AltamarMx/LabModularCalor/practicas/README.md

# Guía de prácticas del Laboratorio Modular de Transferencia de Calor

La presente guía de prácticas es un conjunto reducido de experimentos
que se pueden llevar a cabo con el **_Laboratorio Modular de Transferencia de Calor (LMTC)_**,
pero debe tener muy conciente la/el lector que la imaginación es el límite.

También es una guía para la/el profesora que imparte el curso de _Transferencia
de Calor_ o su similar.

Te invito a ti, a proponer una práctica y hacer crecer esta sección del LMTC.

Prácticas sugeridas:
1. [Cálculo de la conductividad térmica de una placa](https://github.com/AltamarMx/LabModularCalor/blob/main/practicas/conductividad_termica.md)
2. [Cálculo la resistencia térmica y perfil de temperatura en estado estacionario](https://github.com/AltamarMx/LabModularCalor/blob/main/practicas/resistencia_termica.md)
3. [Efecto de la masa térmica en materiales del mismo espesor y diferente densidad](https://github.com/AltamarMx/LabModularCalor/blob/main/practicas/masa_termica.md)
4. [Coeficiente convectivo](https://github.com/AltamarMx/LabModularCalor/blob/main/practicas/coeficiente_convectivo.md)
5. [Evaluación de disipadores de calor](https://github.com/AltamarMx/LabModularCalor/blob/main/practicas/evaluacion_intercambiador.md)
6. [Intercambio radiativo](https://github.com/AltamarMx/LabModularCalor/blob/main/practicas/intercambio_radiativo.md)
7. [Absortancia solar](https://github.com/AltamarMx/LabModularCalor/blob/main/practicas/absortancia_solar.md)
