AltamarMx/LabModularCalor/practicas/intercambio_radiativo.md

Objetivo: Evaluar el intercambio radiativo como función de la distancia de la fuente radiativa a un punto.

Material:
* 1 Dispositivo de adquisición y visualización de datos o Plataforma IoT
* 1 Dispositivo para medir temperatura y flujo de calor
* 1 Fuente radiativa (foco incandescente, vela, encendedor )

Instrucciones:
Arma el arreglo experimental como se muestra en la figura anexa, coloca el sensor de flujo de calor a una distancia d con la superficie perpendicular a la línea imaginaria que une a la superficie y a la fuente.

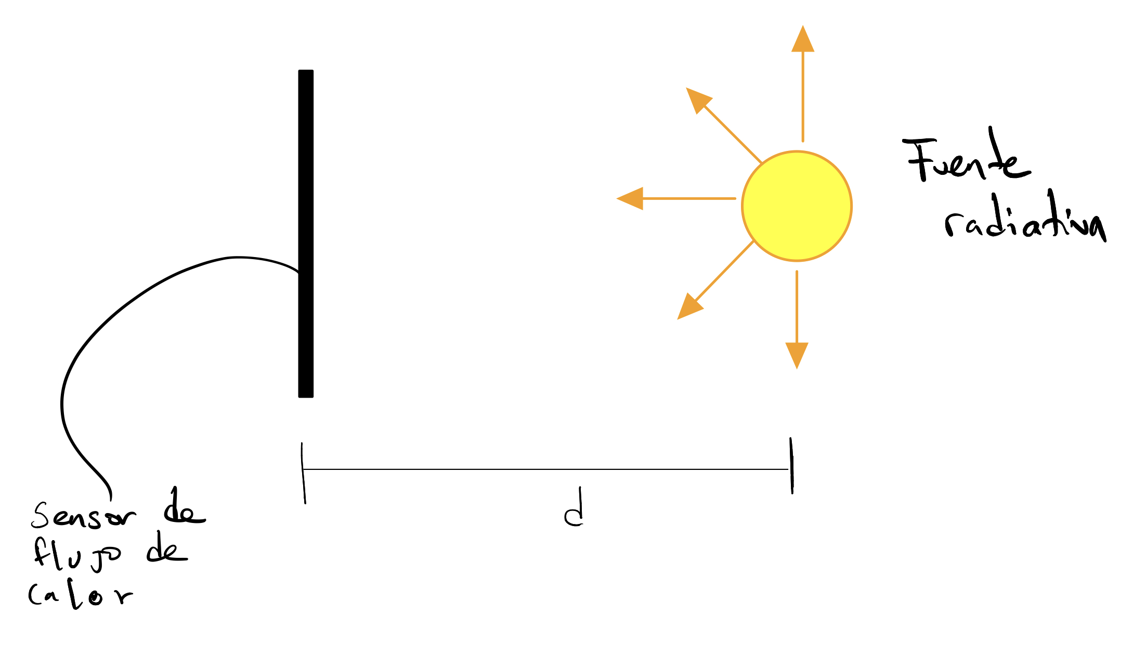
[picture p1: practicas/img/intercambio_radiativo_esquema.jpeg]
“Login”


Mide el flujo de calor que registra el sensor a diferentes distancias.
Cambia la orientación del sensor hacia la fuente de luz y mide otra vez el flujo de calor
a las mismas distancias.

Actividades:
* Grafica el flujo de calor como función de la distancia para una orientación del sensor ¿Qué observas ?
* Grafica el flujo de calor a una distancia y diferentes orientaciones ¿Qué observas?

Actividades sugeridas:
* ¿Qué mediciones necesitas para poder calcular el factor de vista en este experimento?
