AltamarMx/LabModularCalor/practicas/absortancia_solar.md

Objetivo: Evaluar el efecto de la absortancia solar en el intercambio radiativo.

Material:
* 1 Dispositivo de adquisición y visualización de datos o Plataforma IoT
* 1 Dispositivo para medir temperatura y flujo de calor
* 3 cajas de cartón cerradas de 5cm x 5cm x 5cm, una blanca y una negra y una forrada de papel aluminio.

Instrucciones:
Arma el arreglo experimental como se muestra en la figura anexa, coloca el sensor de temperatura al centro de la caja cuidando que en las tres cajas quede el  termopar en la misma posición.

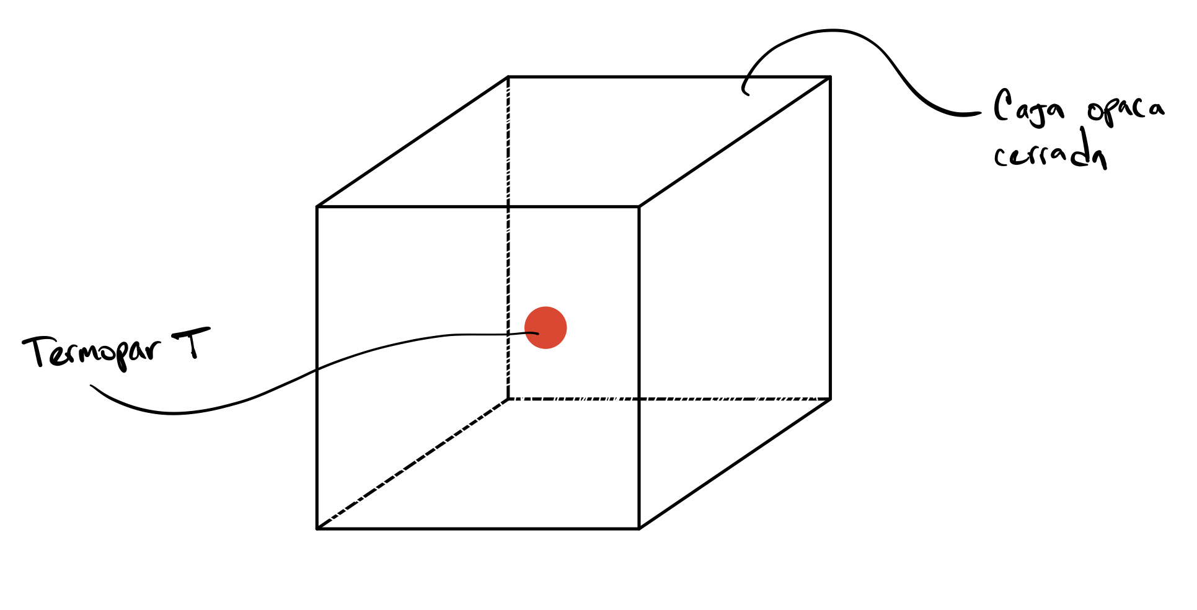
[picture p2: practicas/img/absortancia_solar_esquema.jpeg]
“Login”


Saca las tres cajas al sol cuidando que no se produzcan sombreamientos entre ellas y que tampoco reciban sombreamiento
por otros elementos.

Actividades:
* Mide la temperatura del aire como función del tiempo ¿Qué observas?

Actividades sugerias:
* Calculando el volumen de aire de la caja, y asumiendo que un calor específico constante, calcula el flujo de calor
solar recibido por cada caja.
