AltamarMx/LabModularCalor/practicas/evaluacion_intercambiador.md

Objetivo: Evaluar dos disipadores de calor.

Material:
* 1 Dispositivo de adquisición y visualización de datos o Plataforma IoT
* 1 Dispositivo para medir temperatura y flujo de calor
* 1 Dispositivos de condición de frontera a temperatura constante
* 2 disipadores de calor de aleta
* Pasta térmica para unir las piezas

Instrucciones:
Consigue 2 intercambiadores de calor diferentes, es importante que sea diferentes como los mostrados a continuación:

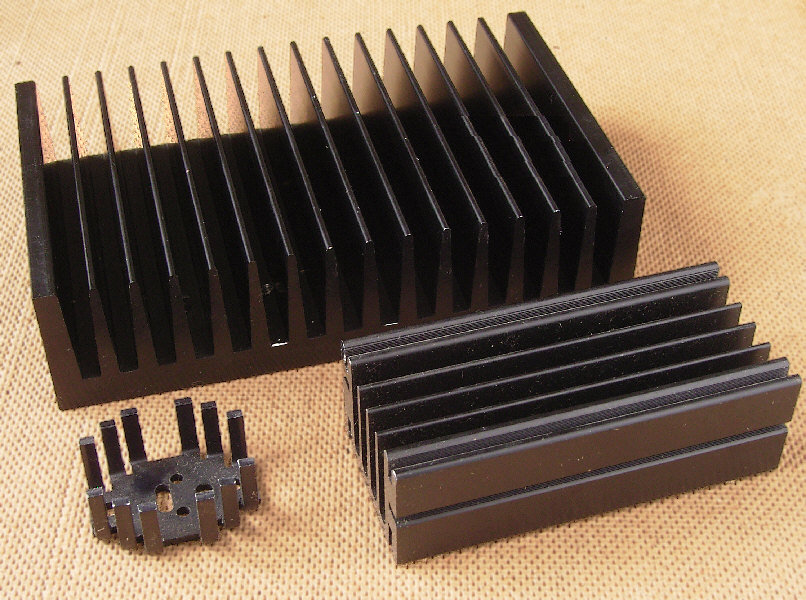
[picture p3: practicas/img/disipador1.jpg]


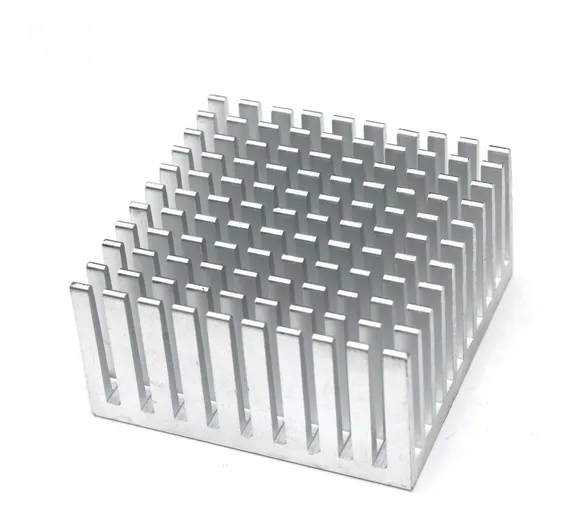
[picture p4: practicas/img/disipador2.png]
 

Arma el arreglo experimental como se muestra en la figura anexa,  establece la celda Peltier a temperatura constantes. Coloca el sensor de flujo de calor.

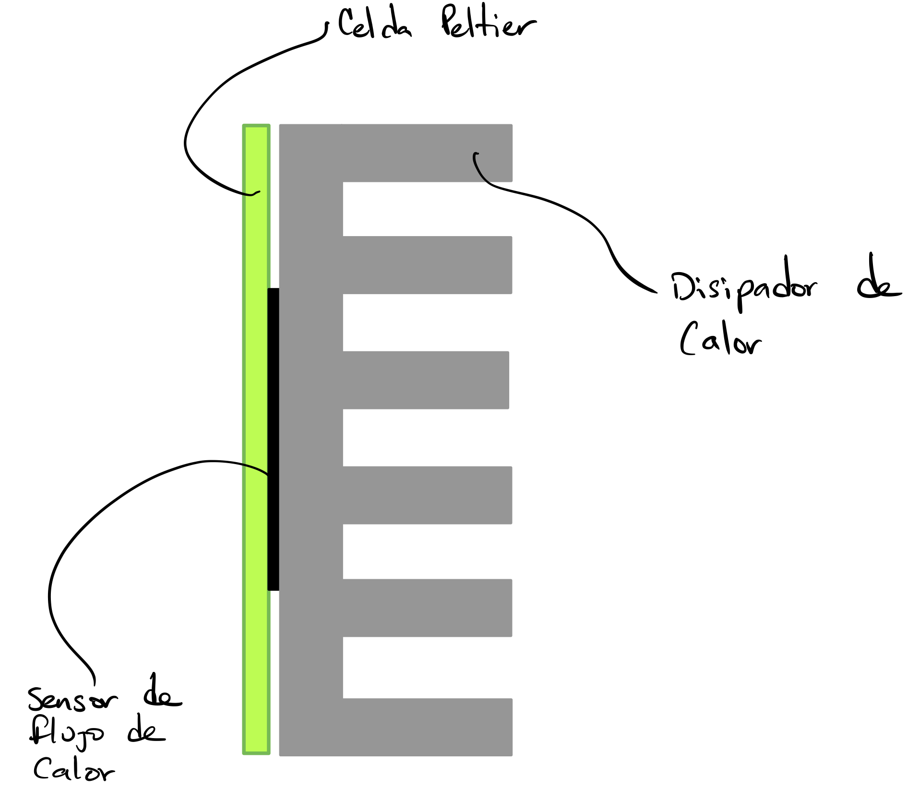
[picture p5: practicas/img/disipador_esquema.jpeg]


Mide el flujo de calor y espera a alcanzar el estado permanente. Cálcula el coeficiente convectivo.
Cambia el disipador de calor y vuelve a medir el flujo de calor y a calcular el coeficiente convectivo.

Actividades:
* Compara los valores de flujo de calor de los dos disipadores ¿Qué observas?
* Compara los valores calculados del coeficiente convectivo en los dos disipadores ¿Qué observas?

Actividades sugeridas:
* Cambia la orientación del disipador de calor ¿Observas alguna diferencia?
* Si rocias un poco de alcohol sobre el disipador ¿Observas alguna diferencia?
