AltamarMx/LabModularCalor/practicas/coeficiente_convectivo.md

Instrucciones:

Objetivo: Analizar el efecto del viento en el coeficiente convectivo.

Material:
* 1 Dispositivo de adquisición y visualización de datos o Plataforma IoT
* 1 Dispositivo para medir temperatura y flujo de calor
* 1 Dispositivos de condición de frontera a temperatura constante
* Pasta térmica para unir piezas
* 1 Ventilador

Instrucciones:

Arma el arreglo experimental como se muestra en la  figura, coloca cada uno de los dispositivos de condición de frontera a temperaturas diferentes y valores constantes. Coloca un sensor de flujo de calor y un termopar
sobre la celda Peltier. Mide también la temperatura ambiente. Establece la celda Peltier a un valor constante.

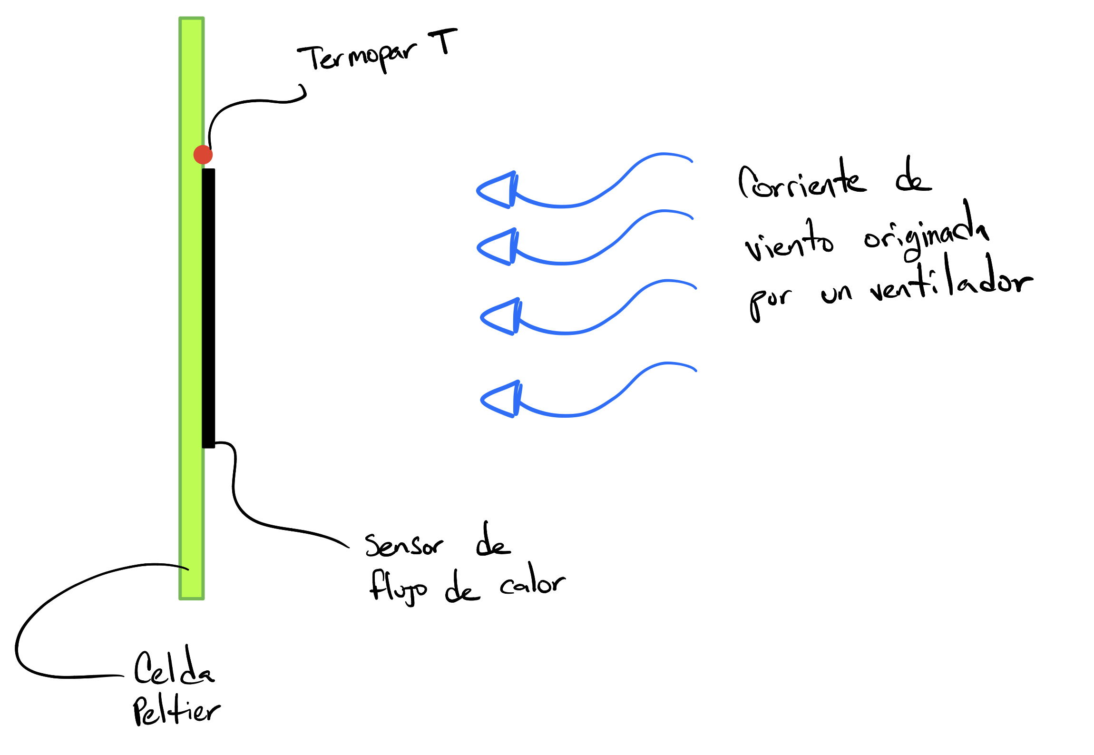
[picture p6: practicas/img/coeficiente_convectivo_esquema.jpeg]
“Login”


Mide la temperatura de la superficie de la celda Peltier, la temperatura del aire y el flujo de calor.
Calcula el coeficiente convectivo usando la formula:
q/A = h dT
donde q/A es el flujo de calor por unidad de área medido por el sensor de flujo de calor, h es el coeficiente convectivo y dT la diferencia de temperatura entre la superficie y el ambiente.
Varía la velocidad del aire y calcula el coeficiente convectivo para cada velocidad diferente.

Realiza las siguientes actividades:
* Compara los cálculos de los diferentes coeficientes convectivos para las diferentes velocidades del aire ¿Qué observas?
* Compara las mediciones de flujo de calor para los diferentes experimentos ¿Qué observas?

Actividades sugeridas:
*  Utiliza una correlación del coeficiente convectivo para determinar de manera indirecta la velocidad del viento.
