AltamarMx/LabModularCalor/practicas/resistencia_termica.md

Objetivo: Medir la resistencia térmica de un conjunto de capas homogéneas y visualizar
el perfil de temperaturas en estado estacionario.

Material:
* 1 Dispositivo de adquisición y visualización de datos o Plataforma IoT
* 2 Dispositivo para medir temperatura y flujo de calor
* 2 dispositivos de condición de frontera a temperatura constante
* 3 muestras de diferente material de  1" x 1" con espesor de máximo 1 cm
* Pasta térmica para unir las piezas

Instrucciones:

Arma el arreglo experimental como se muestra en la  figura, coloca cada uno de los dispositivos de condición de frontera a temperaturas diferentes y valores constantes. Coloca dos sensores de flujo de calor y cuatro
termopares como se indica en la figura.

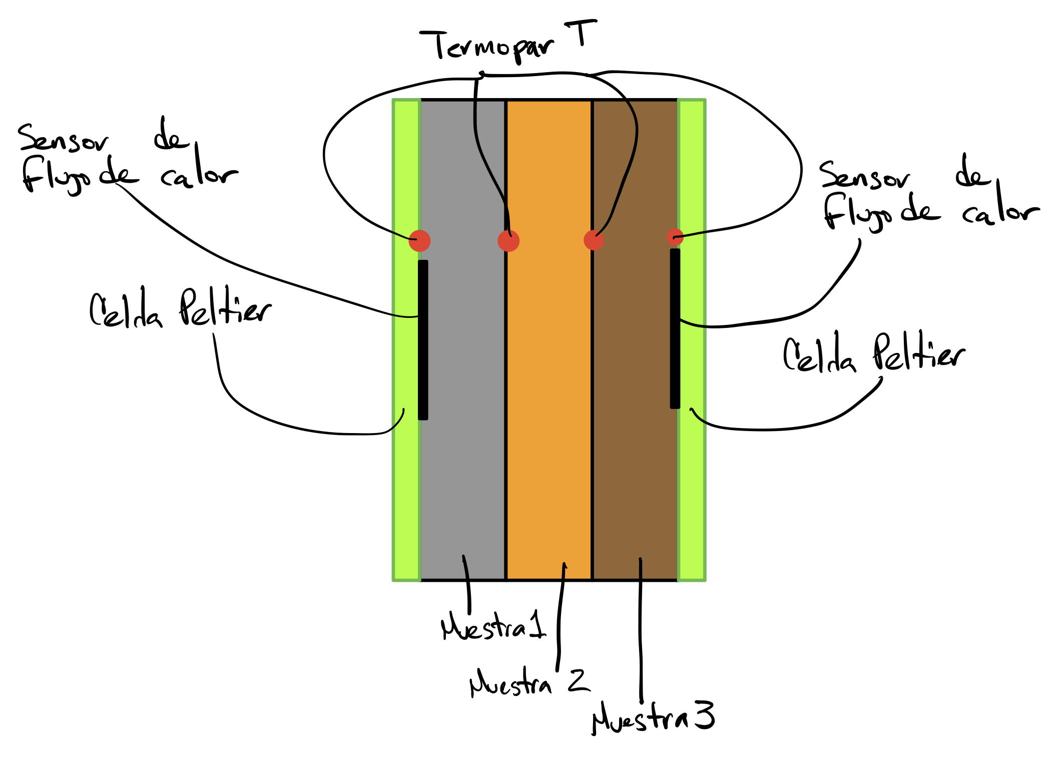
[picture p7: practicas/img/resistencia_esquema.jpeg]
“Login”


Visualiza los valores de temperatura y flujo de calor en los dispositivos de adquisición. Una vez que el sistema ha alcanzado el estado permanente usa esos valores de temperatura y flujo de calor para calcular la resistencia térmica usando la siguiente ecuación:

q/A = dT /  Rt

donde q es el flujo de calor, A es el área de la muestra, dT la diferencia de temperatura entre las superficies y Rt la resistencia térmica de la muestra.

Realiza las siguientes actividades:
Establece la temperatura de las celdas Peltier a diferentes temperaturas y calcula para cada dT la resistencia térmica y grafica este valor. ¿Qué observas?

Actividades sugeridas:
* Calcula y grafica el perfil de temperatura que debe tener una muestra con una resistencia térmica equivalente, grafica y compara con los datos experimentales y comenta las semejanzas o diferencias.
* Intercambia el orden de las muestras y vuelve a realizar los experimentos.
