AltamarMx/LabModularCalor/practicas/conductividad_termica.md

Objetivo: Medir la conductividad térmica de diferentes muestras de materiales homogénes de una sola capa.

Material:
* 1 Dispositivo de adqusición y visualización de datos o Plataforma IoT
* 1 Dispositivo para medir temperatura y flujo de calor
* 2 dispositivos de condición de frontera a temperatura constante
* 2 muestras de diferente material de  1" x 1" con espesor de máximo 1 cm
* Pasta térmica para unir las piezas

Instrucciones:
Arma el arreglo experimental como se muestra en la figura anexa, coloca cada uno de los dispositivos de condición de frontera a temperaturas diferentes y valores constantes. Coloca dos sensores de flujo de calor y dos termopares como se indica en la figura.

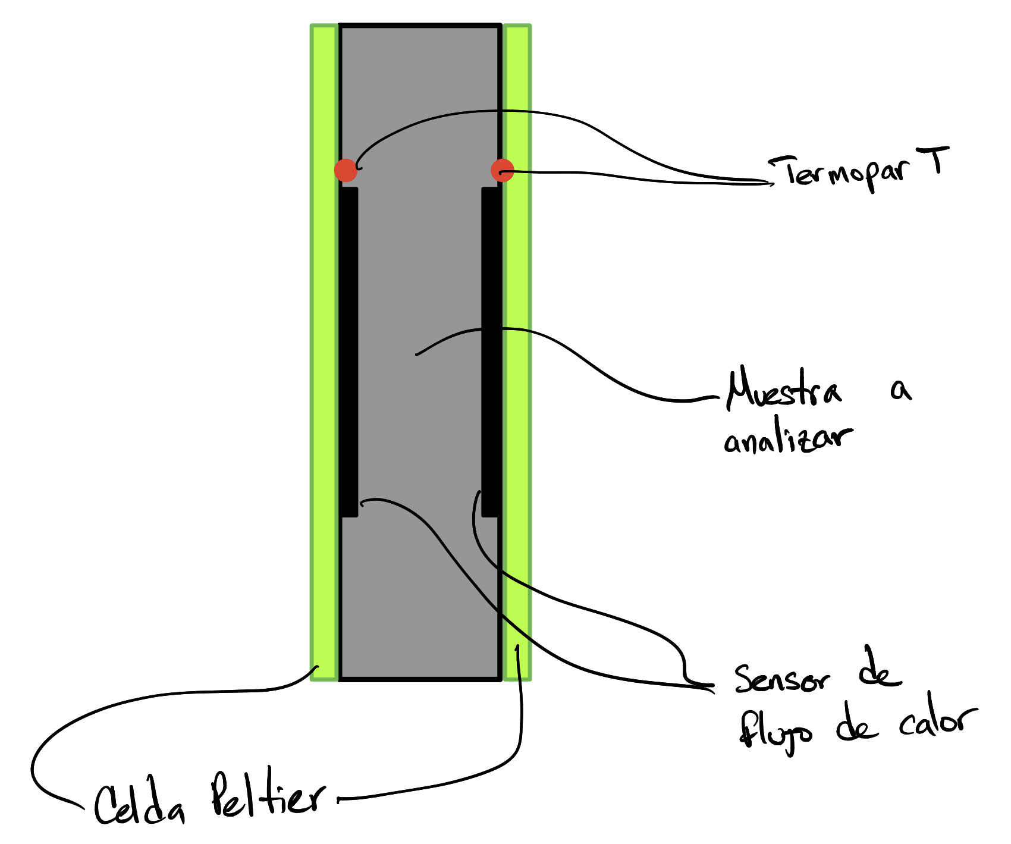
[picture p8: practicas/img/conductividad_esquema.jpeg]
“Login”


Visualiza los valores de temperatura y flujo de calor en el dispositivo de adquisición y visualización de datos o en la platoaforma IoT.
Una vez que el sistema ha alcanzado el estado permanente usa esos valores de temperatura y flujo de calor para calcular la conductividad térmica usando la siguiente ecuación:

q/A  = k dT / L

donde q es el flujo de calor, A es el área de la muestra, k la conductividad térmica, dT la diferencia de temperatura entre las superficies y L el espesor de la muestra.

Una vez que el experimento ha alcanzado el estado permanente, saca promedios de las lecturas durante el estado permanente , y repite para otra muestra.
Reporta los valores obtenidos para las dos muestras y comenta si los resultados son los esperados.

Actividades sugeridas:
* Demuestra con los valores de temperatura que el sistema ha alcanzado el estado permanente.
* Demuestra utilizando los sensores de flujo de calor, que el sistema ha alcanzado el estado permanente.
* Calcula y grafica la derivada temporal de la temperatura respecto al tiempo y comenta el comportamiento.
