AltamarMx/LabModularCalor/dispositivos/d3.md

# Dispositivo para generar condiciones de frontera

Este dispositivo genera condiciones de frontera de temperatura constante o una señal que varía sinusoidalmente en el tiempo.

Esto se logra con un microcontrolador esp8266, una placa Peltier, una fuente de alimentación, y una pantalla LCD para la interfaz. Dado que la placa Peltier requiere hasta 10 A de corriente, se requiere una fuente de potencia que entregue esta corriente y otra a 5V y 1 A para alimentar el esp8266. Además se cuenta con dos programas, uno para la condición de temperatura constante y otro para la condición de temperatura dependiente del tiempo.

El dispositvo ensamblado abierto y encendido se ve así:

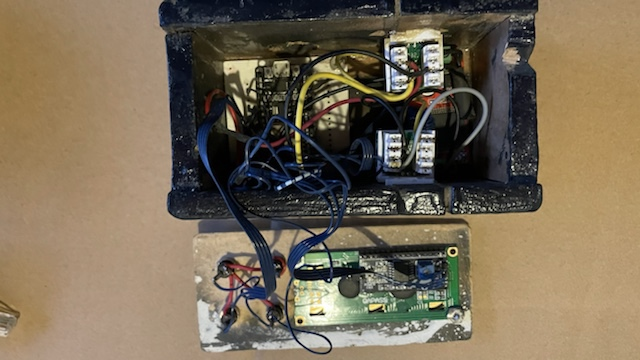
[picture p9: dispositivos/img/d3_abierto.jpeg]


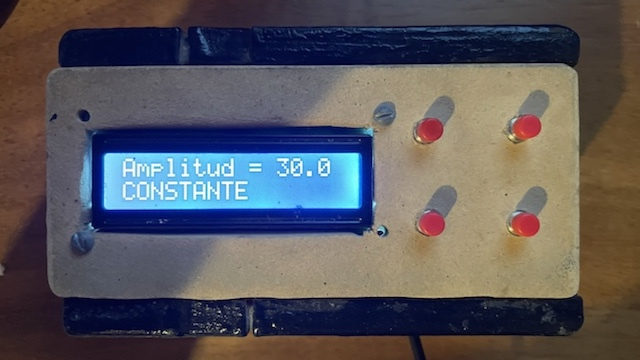
[picture p10: dispositivos/img/d3_encendido.jpeg]
 

En este caso, se cuentan con dos códigos:
1. [Condición de temperatura constante](https://github.com/AltamarMx/LabModularCalor/tree/main/dispositivos/d3/src/constante)
2. [Condición de temperatura sinusoidal](https://github.com/AltamarMx/LabModularCalor/tree/main/dispositivos/d3/src/sinusoidal)

El procedimiento para subir los programas al esp8266 son [estos](https://www.youtube.com/playlist?list=PLxG3HSH9-XK0j2GOKXZKbhOFE_pmVcxUO).

La lista de piezas es :  

1. 1 [esp8266](https://listado.mercadolibre.com.mx/esp8266#D[A:esp8266,L:undefined])
2. circuito de potencia para la celda Peltier basado en [Shield Monster Driver 30a Vnh2sp30 Puente H Pwm Arduino](https://articulo.mercadolibre.com.mx/MLM-563513242-puente-h-doble-30a-monster-moto-shield-vnh2sp30-arduinorobot-_JM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)
3. [Celda Peltier con disipador](https://articulo.mercadolibre.com.mx/MLM-690217405-kit-disipador-ventilador-celda-peltier-4x4cm-_JM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)
4. [Pantalla LCD](https://www.amazon.com.mx/tresd-print-tech-Pantalla-Compatible/dp/B08KL1H8F1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)
5. Fuente de potencia de 350 W con salidas de 3.3 V y 5 V

El esquemático de este dispositivo es:
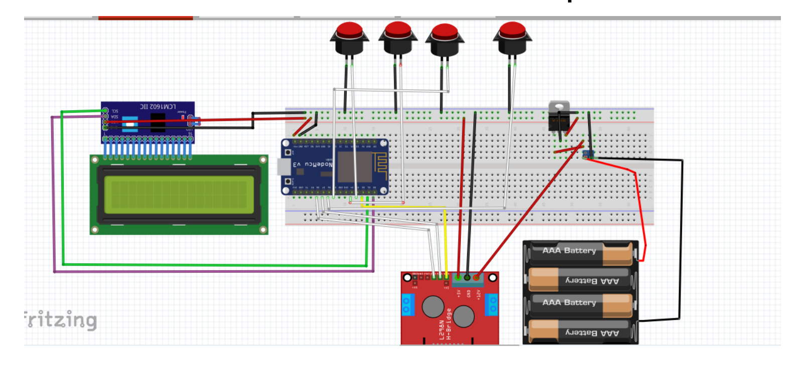
[picture p11: dispositivos/img/d3_esquematico.png]
