AltamarMx/LabModularCalor/dispositivos/d1.md

# Dispositivo de adquisición y visualización de datos

Este dispositivo se encarga de la adquisici'on y visualizaci'on de datos en tiempo real para los casos en que no se cuenta con una conexión inalámbrica a internet.

 Esto se logra con una RaspBerry Pi 3 en adelante, la instalación y configuración de ThingsBoard, que es una plataforma IoT y de la configuración correcta de la RaspBerry Pi.

 La lista de componentes es :  

 1. 1 RaspBerry Pi 3 en adelante
 2. Plataforma IoT ThingsBoard
 3. Tarjeta miniSD de al menos 4 GB y alta velocidad

Las instrucciones para instalar la plataforma IoT ThingsBoard
en la RaspBerry Pi se encuentran [aquí](https://thingsboard.io/docs/user-guide/install/rpi/)
