AltamarMx/LabModularCalor/dispositivos/d2.md

# Dispositivo para medir temperatura y flujo de calor

Este dispositivo es capaz de medir la temperatura en 4 puntos y el flujo de calor en una superficie de 1 pulgada cuadrada, adem'as, se conecta a la plataforma de IoT ThingsBoard donde se almacenan y visualizan los resultados en tiempo real.

 Esto se logra con un Arduino UNO, un esp8266, un shield para 4 termopares, un sensor de flujo de calor basado en efecto termopila, un circuito de ganancia para amplificar la señal del sensor de flujo de calor y el programa configurando una red inalámbrica para conectarse a la plataforma IoT.

 El dispositvo ensamblado abierto, junto con el sensor de flujo de calor se ve así:

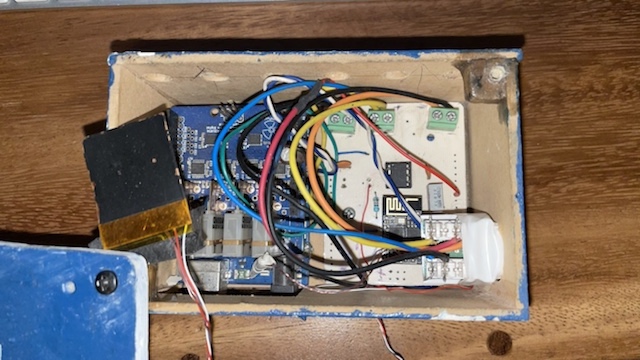
[picture p12: dispositivos/img/d2.jpeg]
 

 En este caso, se cuentan con un código:
 1. [Lectura de termopares, sensor de calor y publicación en ThingsBoard](https://github.com/AltamarMx/LabModularCalor/blob/main/dispositivos/d2/src/termopares_flujocalor_publicar.ino)

El esquemático del circuito de ganancia es:

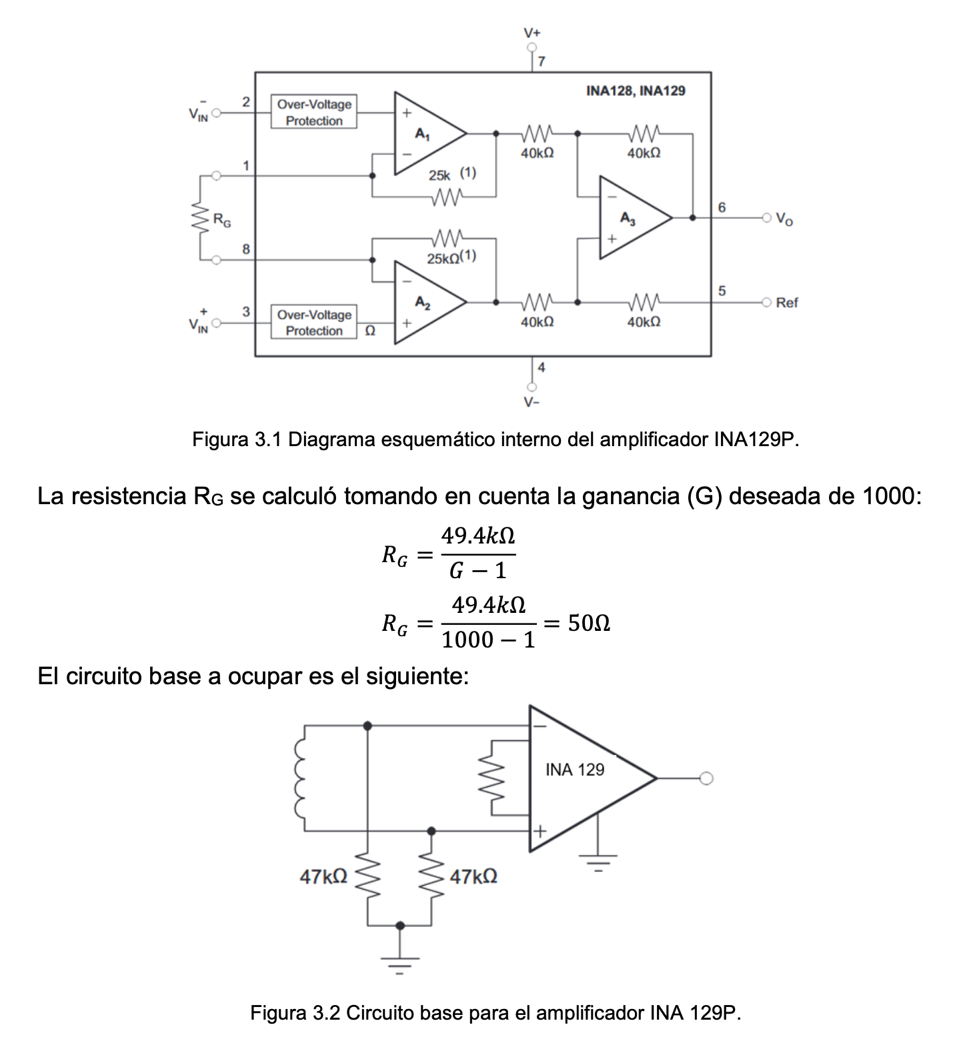
[picture p13: dispositivos/img/d2_esquematico_ganancia.png]
 

El esquemático del dispositivo completo es:

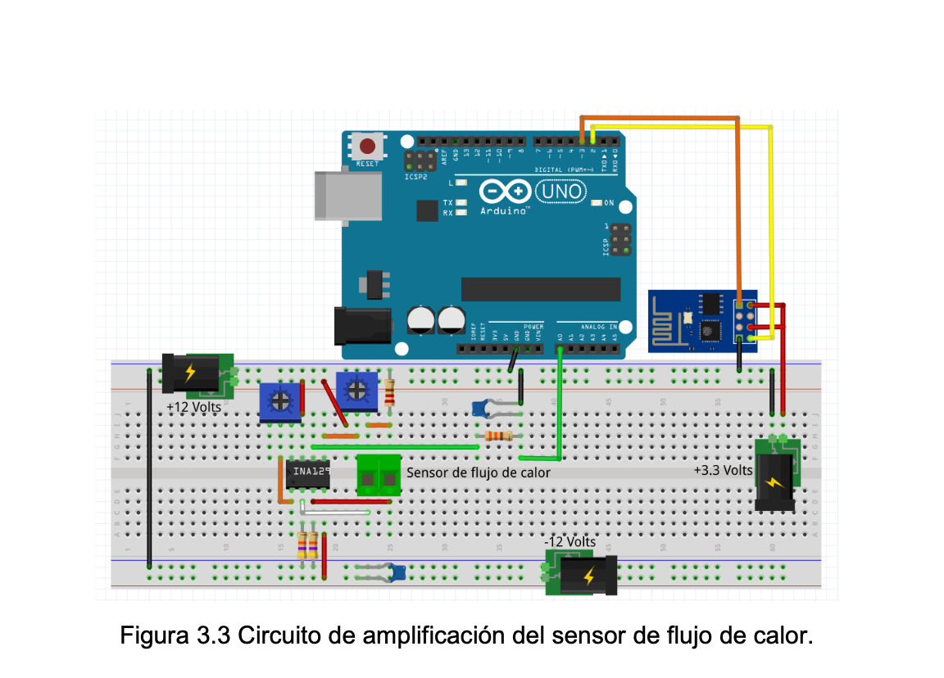
[picture p14: dispositivos/img/d2_esquematico_completo.png]
“d2_completo”
 

 La lista de piezas es :  

 1. 1 [Arduino Uno](https://store.arduino.cc/usa/arduino-uno-rev3)
 2. 1 [Shield para 4 termopares tipo T](https://www.playingwithfusion.com/productview.php?catid=1004&pdid=71)
 3. 1 [Sensor de flujo de calor](https://www.fluxteq.com/phfs-01e-heat-flux-sensor)
 4. 1 [esp12e](https://articulo.mercadolibre.com.mx/MLM-555159182-modulo-wifi-esp8266-esp-12f-esp8266-actualizacion-esp-12e-esp-12-compatible-con-arduino-nodemcu-_JM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)
 5. 4 Termopares tipo T
 6. 1 circuito de ganancia basado en el [INA129P](https://www.infinity-component.hk/product/Luminary-Micro-Texas-Instruments_INA129P.aspx)
