AltamarMx/LabModularCalor/dispositivos/d4.md

# Dispositivo simplificado para medir temperatura

Es el dispositivo más fácil y barato de recrear,
cuenta con 4 sensores digitales de temperatura conectados a un esp8266 con MicroPython, pero se pueden agregar más . Solo requiere configurar la red inalámbrica a la que se debe conectar y energizarse por medio de un cable micro USB por medio de una computadora, batería o cargador de celular.

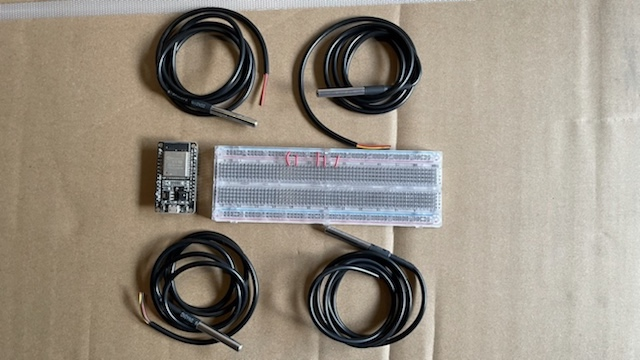
[picture p15: dispositivos/img/d4.jpeg]
“Login”


El código que se tiene que colocar en el esp8266 está [aquí](https://github.com/AltamarMx/LabModularCalor/tree/main/dispositivos/d4/src), y los videos
que explican como hacerlo [aquí](https://www.youtube.com/playlist?list=PLxG3HSH9-XK0j2GOKXZKbhOFE_pmVcxUO).

La lista de material es :  

1. 1 [esp8266](https://listado.mercadolibre.com.mx/esp8266#D[A:esp8266,L:undefined])
2. 4 [ds18b20](https://listado.mercadolibre.com.mx/ds18b20#D[A:ds18b20,L:undefined])
3. 1 [Protoboard](https://articulo.mercadolibre.com.mx/MLM-603893885-protoboard-400-puntos-_JM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)
4. 1 [cable microUSB para datos](https://articulo.mercadolibre.com.mx/MLM-565031638-adata-cable-micro-usb-celular-v8-original-carga-y-datos-tela-_JM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)
5. 1 [fuente alimentación USB](https://articulo.mercadolibre.com.mx/MLM-648560850-turbo-cargador-pared-led-carga-rapida-doble-puerto-usb-_JM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) o bateria con entrada USB.
