AltamarMx/LabModularCalor/dispositivos/plataforma.md

# Plataforma IoT

Si se cuenta con una conexión a internet inalámbrica, el dispositivo para medir temperaturas y flujo de calor y el dispositivo simplificado para medir temperaturas, se pueden conectar una plataforma IoT que tenemos disponible para este objetivo.

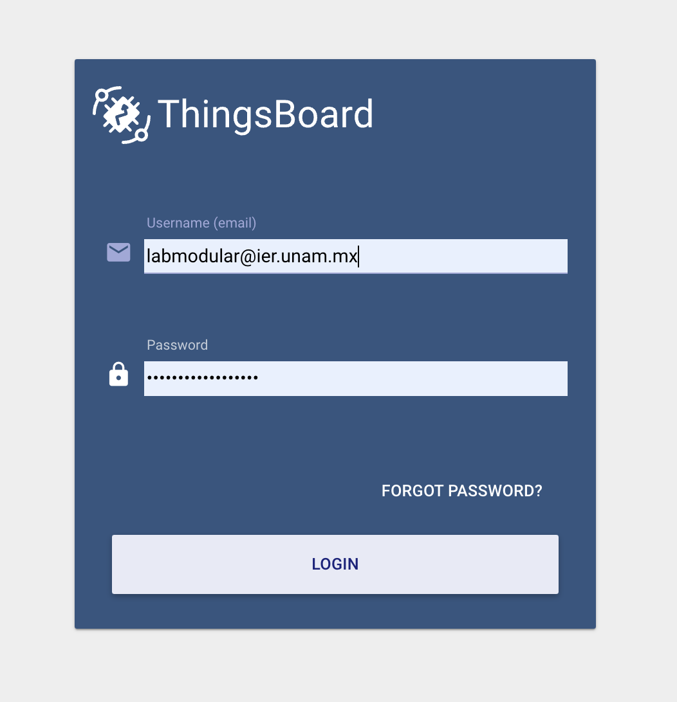
[picture p16: dispositivos/img/login.png]
“Login”


En la plataforma, se puede encontrar el tablero de cada LMTC. Estos tableros serán públicos.
Para tener un tablero se debe solicitar con anticipación y se le hará llegar al solicitante la liga para visualizar los datos junto con  _token_ y un _id_ para poder descargar los datos, si así lo desean.

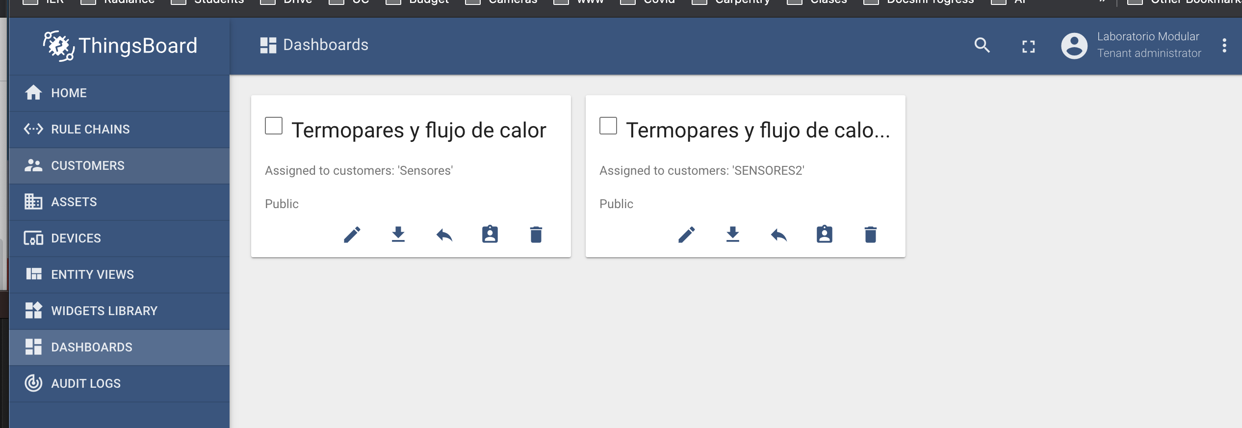
[picture p17: dispositivos/img/dashboards.png]


Si se desea agregar un dispositivo y crear un tablero de visualización, solicitarlo al correo
gbv(at)ier.unam.mx

Para descargar los datos de la plataforma, instala el paquete [iertools.tb](https://github.com/AltamarMx/iertools) paquete y ve [este](https://youtu.be/HVo-CkrcODo) video.
