AltamarMx/LabModularCalor/dispositivos/d3/src/constante/main.py

import machine # Importar librer铆as
import time
import math 
from time import sleep_ms, ticks_ms
from machine import I2C, Pin
from esp8266_i2c_lcd import I2cLcd

i2c = I2C(scl=Pin(5), sda=Pin(16), freq=400000)
lcd = I2cLcd(i2c, 0x3F, 2, 16)

pinA = machine.Pin(0, machine.Pin.IN, machine.Pin.PULL_UP) # Pin de entrada delbot贸n 1
pinB = machine.Pin(2, machine.Pin.IN, machine.Pin.PULL_UP) # Pin de entrada delbot贸n 2

pinX = machine.Pin(13, machine.Pin.OUT) # Pin de control conectado al pin INA delVNH2SP30
pinY = machine.Pin(15, machine.Pin.OUT) # Pin de control conectado al pin INB delVNH2SP30
led = machine.PWM(machine.Pin(4), freq=1000)# configura el PWM con unafrecuencia de 1000 en el pin 4

def pulse (l,t,power): # se definen nuestras variables 
    a = int(power)
    l.duty(abs(a))
    time.sleep_ms(500)
    t = t + 1.
    #print(a)
    print(led)
    return a, t
t = 0.
period = 240.# este es el periodo de nuestro PWM en este circuito no es necesario ya que este sistema es constante.
power = 0.# esta potencia sera variada por el usuario a travez de los botones fisicos, se incrementa y decrementa segun la necesidad del usuario.
    
while True:
    signal, t = pulse(led,t,power)
    if signal > 0:
        pinX.value(-0)
        pinY.value(1)
        if power != 0:
        	print()
    if signal < -0:
        pinX.value(1)
        pinY.value(0)
    	if power != 0:
        	print()
    if pinB.value () ==0:
        power = power + 10
    print (power)
    time.sleep(.1)
    if pinA.value () ==0:
        power = power - 10
    time.sleep(.01)
    lcd.clear()
    z = power
    lcd.move_to(0,0)
    zz = str(z)
    lcd.putstr('Amplitud = ' + zz)
    lcd.move_to(0,1)
    lcd.putstr('CONSTANTE')
